kuba989898/AxxSolder/AxxSolder_hardware/bom/BOM_AxxSolder_V3_2.xlsx

AxxSolder V3.2 | Prises as per 2024-02-20 | Parts for AxxSolder Portable
 |  | Parts for AxxSolder Station
References | Value | Footprint | Manufacturer | MPN | Quantity | Ilość zamówiona Aliexpress | Cena | za szt. | na ile urządzeń | koszt / 1 urządzenie
C3, C9, C14, C15, C16, C17, C18, C21, C22, C23, C24, C25, C26, C27, C28, C29, C33 | 100n | C_0603_1608Metric | KEMET | C0603C104J5RACTU | 17 | 100 | 2.73 zł | 0.03 zł | 5.882352941 | 0.46 zł
C1, C2, C5, C7, C8, C10, C11, C12, C13, C19, C20, C30, C31, C32, C34, C35 | 10u | C_0603_1608Metric | Murata Electronics | GRM188R6YA106MA73J | 16 | 50 | 17.10 zł | 0.34 zł | 3.125 | 5.47 zł
C4, C6 | 1n | C_0603_1608Metric | KEMET | C0603C102K3GAC | 2 | 100 | 2.73 zł | 0.03 zł | 50 | 0.05 zł
C37 | 220u | CAPAE830X1050N | KEMET | EEV227M035A9MAA | 1 | 10 | 11.02 zł | 1.10 zł | 10 | 1.10 zł
R4, R6, R18, R19, R20, R22, R23, R25, R26, R27, R28, R29, R30, R31, R32, R33, R35, R36, R37, R38 | 4k7 | R_0603_1608Metric | Panasonic | ERJ-3RBD4701V | 20 | 100 | 1.00 zł | 0.01 zł | 5 | 0.20 zł
R11, R12, R15, R21, R24 | 22k | R_0603_1608Metric | Panasonic | ERJ-UP3J223V | 5 | 100 | 1.00 zł | 0.01 zł | 20 | 0.05 zł
R1, R5, R14, R17 | 1k5 | R_0603_1608Metric | Panasonic | ERJ-H3ED1501V | 4 | 100 | 1.00 zł | 0.01 zł | 25 | 0.04 zł
R2, R7, R8, R9 | 360k | R_0603_1608Metric | Panasonic | ERJ-3RED3603V | 4 | 100 | 1.00 zł | 0.01 zł | 25 | 0.04 zł
R3, R10 | 220k | R_0603_1608Metric | Panasonic | ERJ-3RED2203V | 2 | 100 | 1.00 zł | 0.01 zł | 50 | 0.02 zł
R13, R16, R34, R43, R46, R47, R48 | 100 | R_0603_1608Metric | Panasonic | ERJ-P03F1000V | 7 | 100 | 1.00 zł | 0.01 zł | 14.28571429 | 0.07 zł
R42 | 5m | RESC6432X89N | Vishay | WSLP25125L000FEA | 1 | 50 | 8.20 zł | 0.16 zł | 50 | 0.16 zł
R44 | 1M | R_0805_2012Metric | Panasonic | ERJ-6GEYJ105V | 1 | 100 | 0.00 zł | 0.00 zł | 100 | 0.00 zł
R45 | 100m | R_0805_2012Metric | Panasonic | ERJ-6DSFR10V | 1 | 100 | 5.70 zł | 0.06 zł | 100 | 0.06 zł
R49,R50 | 10 | R_0603_1608Metric | Panasonic | ERJ-3RED10R0V | 2 | 100 | 1.00 zł | 0.01 zł | 50 | 0.02 zł
L1 | SRP7028CC-150M | INDPM7366X300N | Bourns | SRP7028CC-150M | 1 | 20 | 9.20 zł | 0.46 zł | 20 | 0.46 zł
D5, D6, D7, D8 | BAT54S | SOT95P230X110-3N | Diotec Semiconductor | BAT54S | 4 | 50 | 0.00 zł | 0.00 zł | 12.5 | 0.00 zł
D1, D2 | BAV199WQ-7 | SOT65P210X110-3N | Diodes Incorporated | BAV199WQ-7 | 2 | 100 | 21.50 zł | 0.21 zł | 50 | 0.43 zł
D3, D4 | SMF4L24AT1G | SODFL3619X98N | LITTELFUSE | SMF4L24AT1G | 2 | 50.00 € | 9.00 zł | 0.18 zł | 25 | 0.36 zł
D9, D10 | PMEG6020ER | PMEG6020ER115 | Nexperia | PMEG6020ER,115 | 2 | 100 | 32.00 zł | 0.32 zł | 50 | 0.64 zł
TFT1 | Adafruit_240x320_TFT | Adafruit_240x320_TFT | Adafruit | 4311 | 1 | 2 | 36.00 zł | 18.00 zł | 2 | 18.00 zł
U2 | RIC11-31S15D7-GSMT | RIC11-31S15D7-GSMT | CUI Devices (https://eu.mouser.com/manufacturer/cui-devices/) | RIC11-31S15D7-GSMT | 1 | 5 | 16.00 zł | 3.20 zł | 5 | 3.20 zł
U3 | BSC014N04LS | BSC014N04LS | Infineon Technologies | BSC014N04LSATMA1 | 1 | 5 | 21.50 zł | 4.30 zł | 5 | 4.30 zł
F1 | 0154007.DR | 0154100DR | LITTELFUSE | 0154007.DR | 1 | 50 | 30.00 zł | 0.60 zł | 50 | 0.60 zł
F2 | SF-2410FP100W-2 | SF2410FP100W2 | Bourns | SF-2410FP100W-2 | 1 | 10 | 11.00 zł | 1.10 zł | 10 | 1.10 zł
S2, S3 | ADTSM644RVTR | ADTSM644RVTR | Apem | ADTSM644RVTR | 2 | 0 | 0.00 zł | 0.00 zł |  | 0.00 zł
FB1 | BLM18HE601SN1D | R_0603_1608Metric | Murata Electronics | BLM18HE601SN1D | 1 | 20 | 17.55 zł | 0.88 zł | 20 | 0.88 zł
IC1 | TLV76733DRVR | SON65P200X200X80-7N | Texas Instruments | TLV76733DRVR | 1 | 10 | 6.20 zł | 0.62 zł | 10 | 0.62 zł
IC2 | OPA2387DSGT | SON50P200X200X80-9N | Texas Instruments | OPA2387DSGT | 1 | 10 | 89.00 zł | 8.90 zł | 10 | 8.90 zł
IC3 | LMR54406DBVR | SOT95P280X145-6N | Texas Instruments | LMR54406DBVR | 1 | 10 | 18.00 zł | 1.80 zł | 10 | 1.80 zł
IC4 | STM32G431CBT6 | QFP50P900X900X160-48N | STMicroelectronics | STM32G431CBT6 | 1 | 5 | 82.00 zł | 16.40 zł | 5 | 16.40 zł
IC5 | TPD4E1U06DBVR | SOT95P280X145-6N | Texas Instruments | TPD4E1U06DBVR | 1 | 10 | 8.00 zł | 0.80 zł | 10 | 0.80 zł
IC6 | STUSB4500QTR | QFN50P400X400X100-25N-D | STMicroelectronics | STUSB4500QTR | 1 | 5 | 31.00 zł | 6.20 zł | 5 | 6.20 zł
IC7 | MAX16171ATA_VY+T | SON50P300X200X80-9N | Analog Devices | MAX16171ATA/VY+T | 1 | 5 | 63.00 zł | 12.60 zł | 5 | 12.60 zł
IC8 | LTC4440AHMS8E | SOP65P490X110-9N | Analog Devices | LTC4440AHMS8E-5#PBF | 1 | 6 | 54.00 zł | 9.00 zł | 6 | 9.00 zł
IC9 | INA281A5QDBVRQ1 | SOT95P280X145-5N | Texas Instruments | INA281A5QDBVRQ1 | 1 | 10 | 120.00 zł | 12.00 zł | 10 | 12.00 zł
LS1 | CMI-9653S-SMT-TR | CMI9653SSMTTR | CUI Devices | CMI-9653S-SMT-TR | 1 | 10 | 13.00 zł | 1.30 zł | 10 | 1.30 zł
Q1 | STL9P3LLH6 | STL9P3LLH6 | STMicroelectronics | STL9P3LLH6 | 1 | 5 | 22.25 zł | 4.45 zł | 5 | 4.45 zł
Q2 | STL10N3LLH5 | STL10N3LLH5 | STMicroelectronics | STL10N3LLH5 | 1 | 5 | 30.00 zł | 6.00 zł | 5 | 6.00 zł
Q3 | 2N7002NXAKR | SOT95P230X110-3N | Nexperia | 2N7002NXAKR | 1 | 50 | 20.00 zł | 0.40 zł | 50 | 0.40 zł
J5, J6 | TSW-102-07-T-S | TSW-102-XX-YY-S | SAMTEC | TSW-102-07-T-S | 2 | 0 | 0.00 zł | 0.00 zł |  | 0.00 zł
J1 | USB4110-GF-A | USB4110GFA | GCT | USB4110-GF-A | 1 | 10 | 49.00 zł | 4.90 zł | 10 | 4.90 zł
J2 | 691243110009 | 691243110009 | Wurth Elektronik | 691243110009 | 3 | 50 | 23.00 zł | 0.46 zł | 16.66666667 | 0.00 zł
J4 | 61300611821 | RHDR6W97P0X254_1X6_1574X250X865P | Wurth Elektronik | 61300611821 | 1 | 0 | 0.00 zł | 0.00 zł |  | 0.00 zł
J7 | TSW-108-07-T-S | TSW-108-XX-YY-S | SAMTEC | TSW-108-07-T-S | 1 | 0 | 0.00 zł | 0.00 zł |  | 0.00 zł
SUM Components
Hardware
PCB (Development was done with PCBs from PCBWay, 2 layer, Immersion gold(ENIG) (1U")) + stencil |  |  |  | 1 | €12.62 | 10 | 67.00 zł | 6.70 zł |  | 6.70 zł
Connector for JBC stand (binder 99-0624-00-07) |  |  |  | 1 | €5.11
Connector for soldering iron (HIROSE(HRS) RPC1-12RB-6P(71)) |  |  |  | 1 | €6.11
Power connector (Anderson PP15) BLACK | https://eu.mouser.com/ProductDetail/Anderson-Power-Products/1395G1?qs=yoCgdRjoRtHp7gSzhBTdjg%3D%3D |  |  | 2 | €1.90 | 10 | 16 | 1.60 zł |  | 3.20 zł
Power connector (Anderson PP15) RED | https://eu.mouser.com/ProductDetail/Anderson-Power-Products/1395?qs=yoCgdRjoRtFIuHO4SWqMZA%3D%3D |  |  | 2 | €2.74 | 10 | 16 | 1.60 zł |  | 3.20 zł
Power connector (Anderson PP15) GREEN | https://eu.mouser.com/ProductDetail/Anderson-Power-Products/1395G3?qs=yoCgdRjoRtE1BBke6hIRPA%3D%3D |  |  | 2 | €1.68 | 10 | 16 | 1.60 zł |  | 3.20 zł
Rotary encoder knob | https://eu.mouser.com/ProductDetail/Davies-Molding/1101?qs=byeeYqUIh0PVJzrDf6EcyQ%3D%3D |  |  | 1 | €0.88
Tactile button caps | https://eu.mouser.com/ProductDetail/Omron-Electronics/B32-2000?qs=ZP3UR5XsUocRMlsFF2GtPw%3D%3D |  |  | 2 | €1.71
Rocker Switch | https://eu.mouser.com/ProductDetail/Wurth-Elektronik/471001264143?qs=YCa%2FAAYMW03bZZ%252BoQThfXw%3D%3D |  |  | 1 | €3.45
3D printed housing |  |  |  | 1 | €5.00
Screws - M2.5x12mm countersunk | To mount the PCB to enclosure |  |  | 4 | €0.40
Screws - M2.5x20mm | To mount PP15 connectors |  |  | 1 | €0.10
Screws - M4x8mm | For enclosure to JBS stand |  |  | 1 | €0.40
Screws - M2.5x6mm | To mount HIROSE(HRS) RPC1-12RB-6P(71) |  |  | 4 | €0.40
Screws - M2x8mm + nuts | For the aluminium rest |  |  | 2 | €0.20
Aluminium plate 15x10x2 mm | For the aluminium rest (not mandatory) |  |  | 1 | €1.00
SUM Hardware (portable) |  |  |  |  |  | Wydatki w sumie | 1001.68 zł |  | 2 | 139.39 zł
JBC stand
JBS Stand | https://www.jbctools.com/ad-sf-stand-for-t210-t245-handles-product-2018.html | https://eleshop.eu/jbc-ad-sf-stand-for-t245-and-t210.html |  | 1 | €171.40
Non-genuine Stand
Non-brand Stand | https://www.aliexpress.com/i/1005005756505193.html |  |  | 1 | €17.00
JBC T210 handle piece
T210 handle piece | https://www.jbctools.com/t210-a-precision-handle-product-48.html |  |  | 1 | €66.34
c210-008 tip | https://www.jbctools.com/c210008-chisel-cartridge-13-x-06-product-183.html |  |  | 1 | €38.34
Non-genuine JBC T210 handle piece
Aixun T210 handle piece | https://www.aliexpress.com/item/1005005081918036.html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 |  |  | 1 | €18.00
Aixun c210-008 tip | https://www.aliexpress.com/item/1005005879501637.html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 |  |  | 1 | €17.00
