kuba989898/AxxSolder/AxxSolder_hardware/LCD_change_pin_to_Aliexpress.jpg

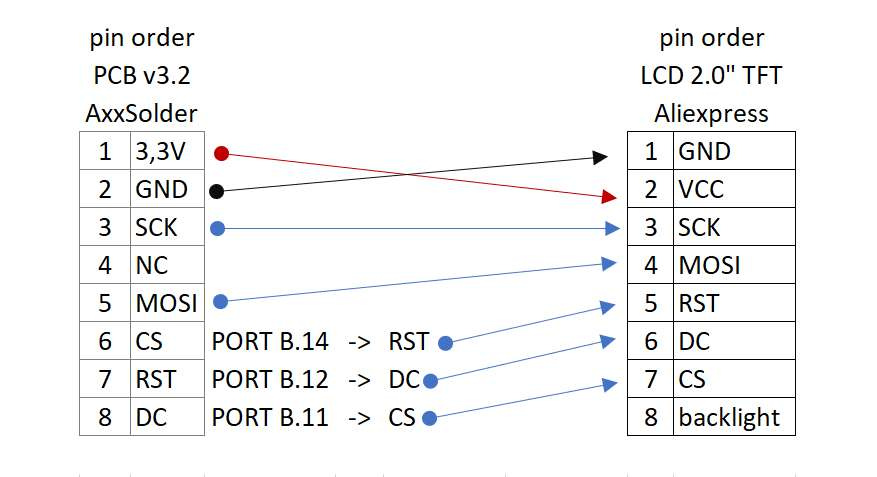
AxxSolder_hardware/LCD_change_pin_to_Aliexpress.jpg
