kuba989898/AxxSolder/AxxSolder_hardware/plots/AxxSolder__Assembly.pdf

1 | 2 | 3 | 4 | 5 | 6

A

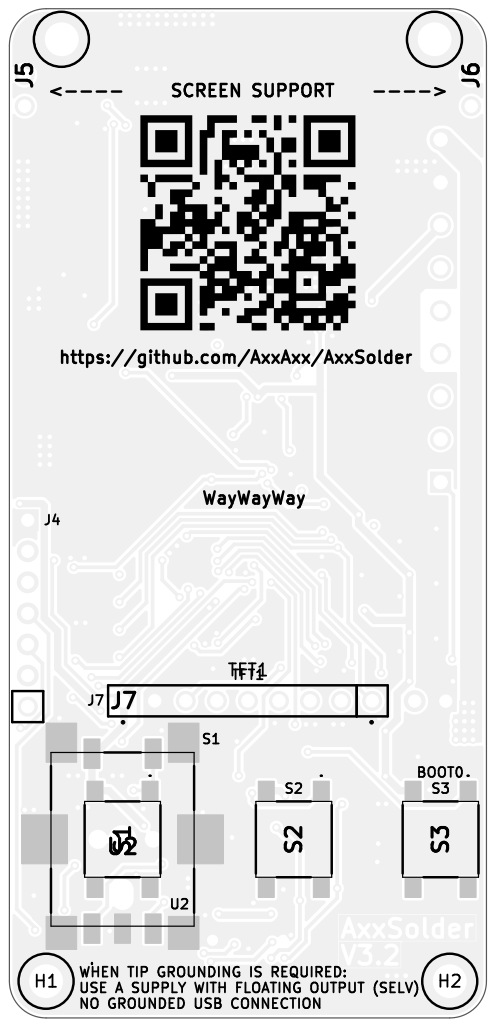
[picture p2: page 1]
https://github.com/AxxAxx/AxxSolder WayWayWay <----; SCREEN SUPPORT; TFT1 S1; D Date: KiCad; E.D.A. 9.0.0 Size: A4; Rev:; Id: /1 Title: File: AxxSolder.kicad_pcb Sheet: Black; And; White; TOP; Board2Pdf:; Black; TOP -; Page; TFT1 S¹

BOOT0 WHEN TIP GROUNDING IS REQUIRED: USE A SUPPLY WITH FLOATING OUTPUT (SELV) NO GROUNDED USB CONNECTION

IC5 C27 1 | 2 | 3 | 4 | 5 | 6 1 | 2 | 3 | 4 | 5 | 6 ABCD | ABCD Date: KiCad E.D.A. 9.0.0 Size: A4 | Rev:

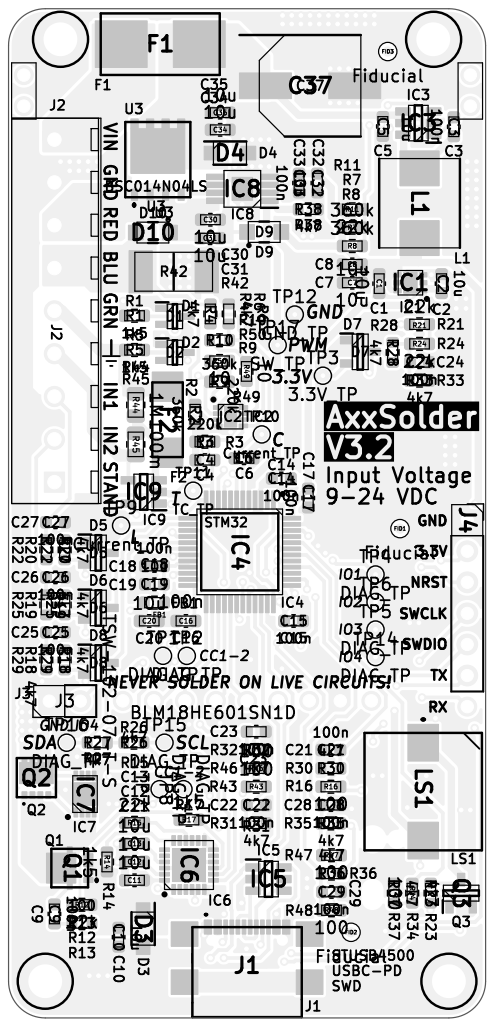
[picture p3: page 2]
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

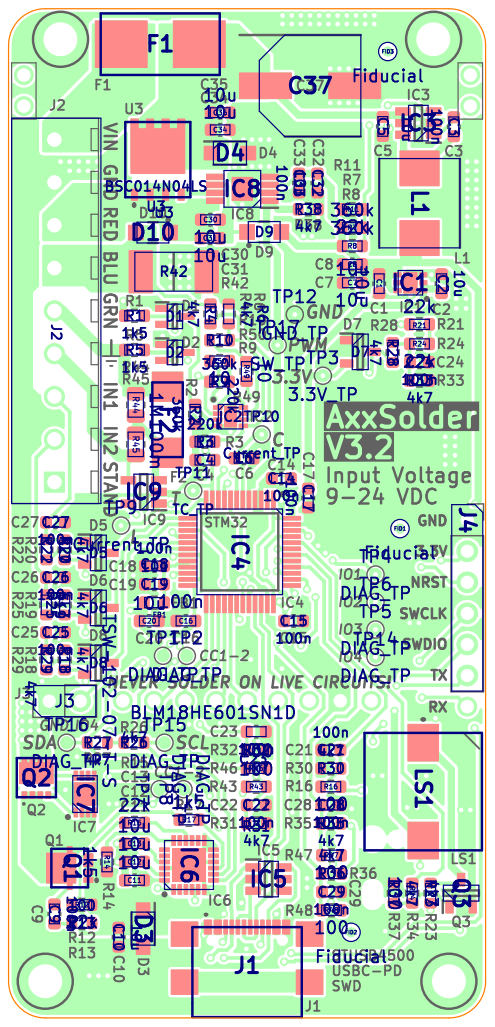
[picture p4: page 3]

A

A

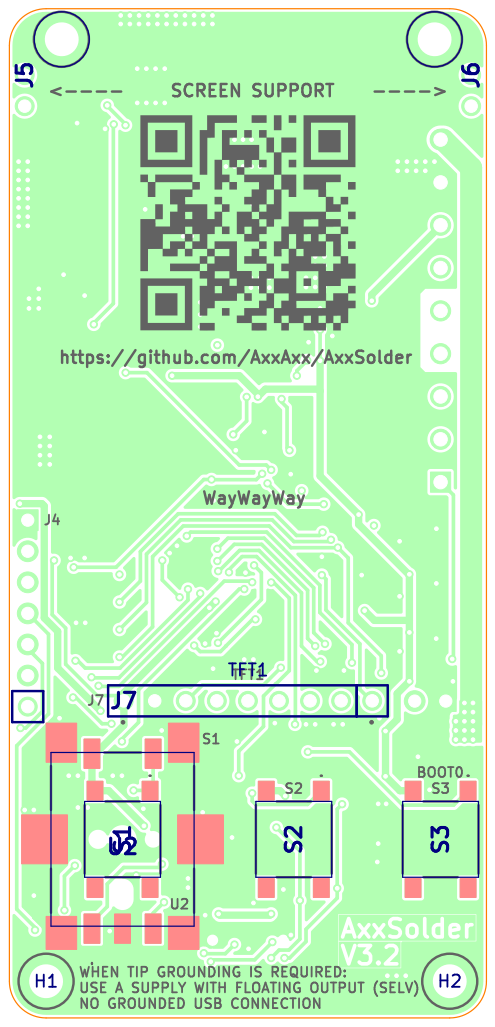
[picture p5: page 4]
https://github.com/AxxAxx/AxxSolder WayWayWay <----; SCREEN SUPPORT; TFT1 S1; D Date: KiCad; E.D.A. 9.0.0 Size: A4; Rev:; Id: /1 Title: File: AxxSolder.kicad_pcb Sheet: Colored; TOP; Board2Pdf:; Colored; TOP -; Page 4/8; TFT1 S¹

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

A

A

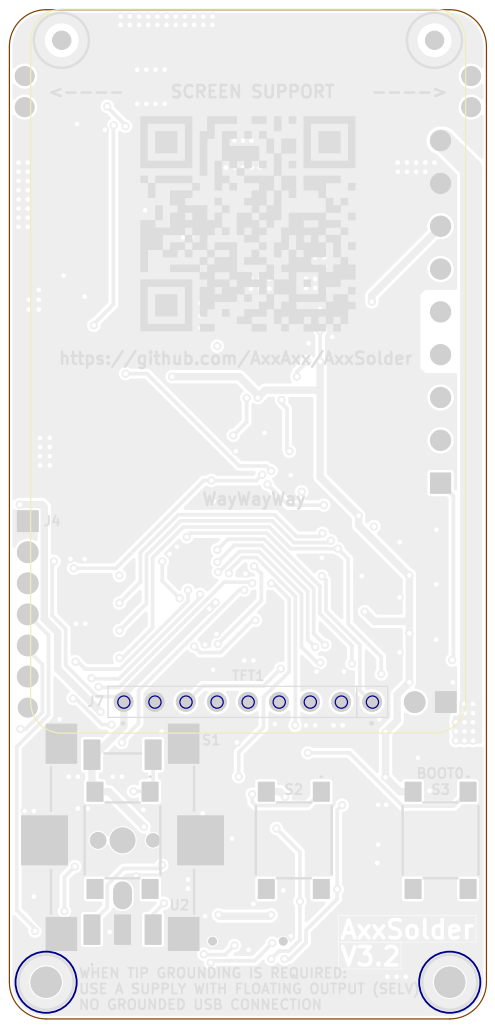
[picture p6: page 5]
https://github.com/AxxAxx/AxxSolder WayWayWay <----; SCREEN SUPPORT; TFT1 S1; D Date: KiCad; E.D.A. 9.0.0 Size: A4; Rev:; Id: /1 Title: File: AxxSolder.kicad_pcb Sheet: Light Colors; PCB; Fabrication; TOP; Board2Pdf:; Light Colors; TOP -; Page 5/8

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

A

A

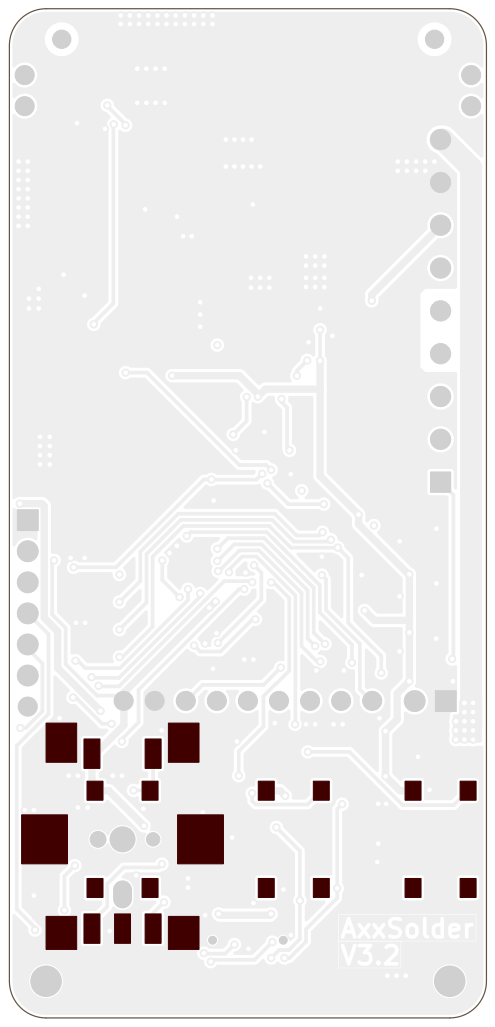
[picture p7: page 6]
D Date: KiCad; E.D.A. 9.0.0 Size: A4; Rev:; Id: /1 Title: File: AxxSolder.kicad_pcb Sheet: Light Colors; PCB; Paste; TOP; Board2Pdf:; Light Colors; TOP -; Page 6/8

100n C27 1 | 2 | 3 | 4 | 5 | 6 1 | 2 | 3 | 4 | 5 | 6 ABCD | ABCD Date: KiCad E.D.A. 9.0.0 Size: A4 | Rev:

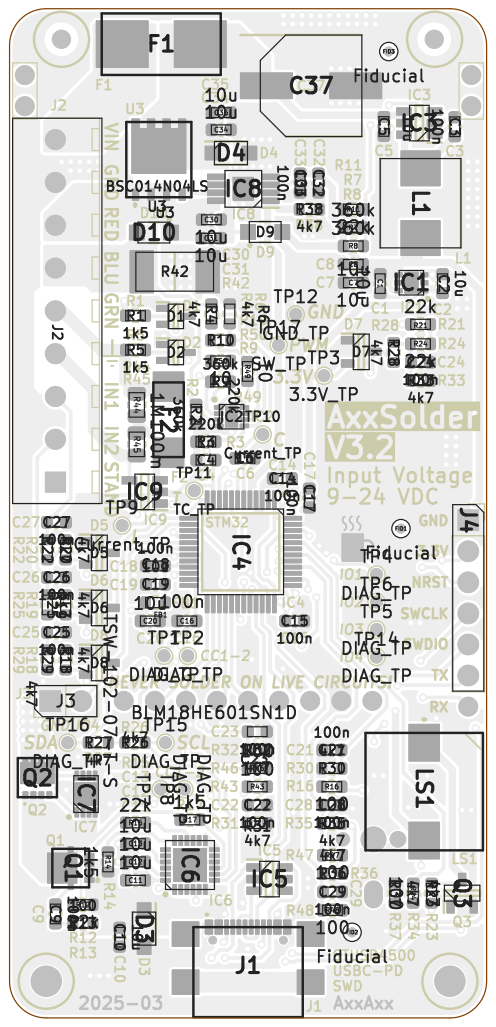
[picture p8: page 7]

A

A

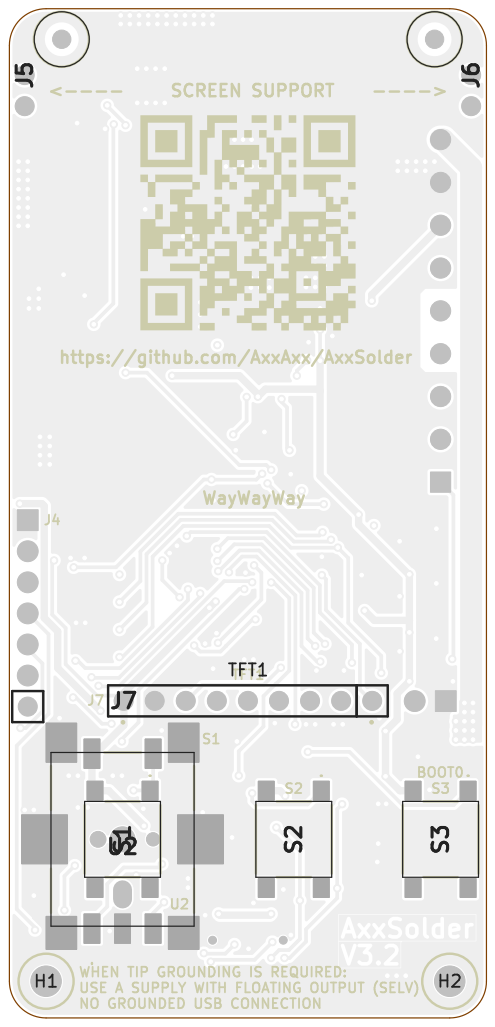
[picture p9: page 8]
https://github.com/AxxAxx/AxxSolder WayWayWay <----; SCREEN SUPPORT; TFT1 S1; TFT1 S¹; D Date: KiCad; E.D.A. 9.0.0 Size: A4; Rev:; Id: /1 Title: File: AxxSolder.kicad_pcb Sheet: Light Colors; Placement; TOP; Board2Pdf:; Light Colors; TOP -; Page 8/8

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
