kuba989898/AxxSolder/AxxSolder_firmware/AxxSolder_firmware.ioc

Mcu.UserName=STM32G431CBTx
PA0.GPIO_Label=ENC_A
PA0.Signal=S_TIM2_CH1
PA1.GPIO_Label=I_LEAK
PA1.Signal=ADC2_IN2
PA10.Signal=USART1_RX
PA13.Signal=SYS_JTMS-SWDIO
PA14.Signal=SYS_JTCK-SWCLK
PA15.Signal=I2C1_SCL
PA2.GPIO_Label=VBUS
PA2.Signal=ADC1_IN3
PA3.GPIO_Label=THERMOCOUPLE
PA3.Signal=ADC1_IN4
PA4.GPIO_Label=HANDLE_INP_1
PA4.Signal=GPIO_Input
PA5.GPIO_Label=HANDLE_INP_2
PA5.Signal=GPIO_Input
PA6.GPIO_Label=STAND_INP
PA6.Signal=GPIO_Input
PA7.GPIO_Label=SW_2
PA7.Signal=GPXTI7
PA8.GPIO_Label=USR_1
PA8.Signal=GPIO_Output
PA9.Signal=USART1_TX
PB0.GPIO_Label=USR_2
PB0.Signal=GPIO_Output
PB1.GPIO_Label=USR_3
PB1.Signal=GPIO_Output
PB10.GPIO_Label=SPI2_SD_CS
PB10.Signal=GPIO_Output
PB11.GPIO_Label=SPI2_CS
PB11.Signal=GPIO_Output
PB12.GPIO_Label=SPI2_DC
PB12.Signal=GPIO_Output
PB13.Signal=SPI2_SCK
PB14.GPIO_Label=SPI2_RST
PB14.Signal=GPIO_Output
PB15.Signal=SPI2_MOSI
PB2.GPIO_Label=USR_4
PB2.Signal=GPIO_Output
PB3.GPIO_Label=ENC_B
PB3.Signal=S_TIM2_CH2
PB5.GPIO_Label=SW_1
PB5.Signal=GPXTI5
PB7.GPIO_Label=BUZZER
PB7.Signal=S_TIM4_CH2
PB8-BOOT0.GPIO_Label=SW_3
PB8-BOOT0.Signal=GPXTI8
PB9.Signal=I2C1_SDA
PC13.GPIO_Label=VERSION_BIT_1
PC13.Signal=GPIO_Input
PC14-OSC32_IN.GPIO_Label=VERSION_BIT_2
PC14-OSC32_IN.Signal=GPIO_Input
PC15-OSC32_OUT.GPIO_Label=VERSION_BIT_3
PC15-OSC32_OUT.Signal=GPIO_Input
PF0-OSC_IN.GPIO_Label=HEATER
PF0-OSC_IN.Signal=TIM1_CH3N
PF1-OSC_OUT.GPIO_Label=CURRENT
PF1-OSC_OUT.Signal=ADC2_IN10
