kuba989898/AxxSolder/(commit log)

2025-11-12 zmiany na pcb
    [AxxSolder.kicad_pcb, AxxSolder.kicad_sch]
2025-11-12 update BOM to own parts
    Added own prices from Aliexpress, for part sourced from Aliexpress.
    [BOM_AxxSolder_V3_2.xlsx]
2025-11-13 progress in assembly
    [BOM_AxxSolder_V3_2.xlsx]
2025-11-13 update in assembly
2025-11-14 adding power graph
